EnzoSenatori/Geratrix_IoT_front/docs/referencias/fotos-esp32/esp32-1.jpeg

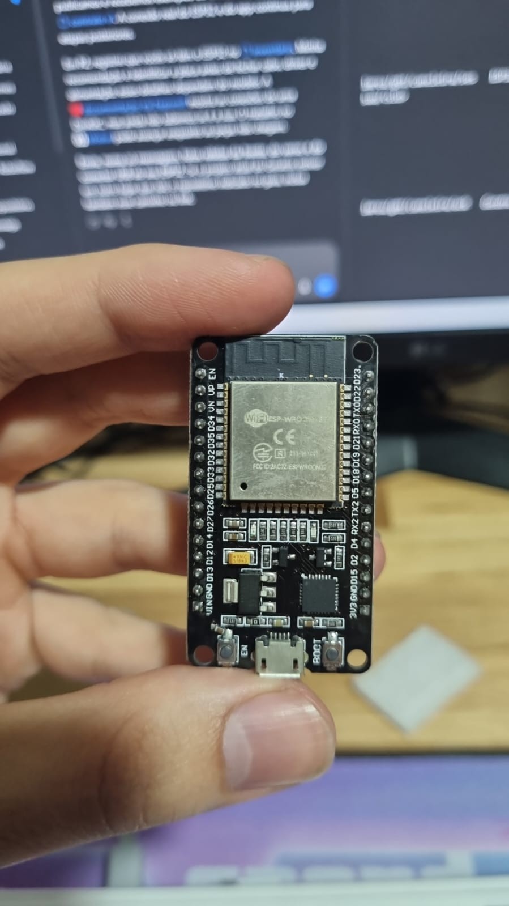
docs/referencias/fotos-esp32/esp32-1.jpeg
