EnzoSenatori/Geratrix_IoT_front/firmware/caneleira/README.md

# Firmware da caneleira

**Estado em 06/11/2026.** O P3 (leitura da IMU a 100 Hz) foi verificado no Wokwi em 13/10. Os passos P5 a P7 (filtro, contagem e classificação das repetições, resumo da série) estão implementados, verificados em simulação no computador e executados no Wokwi em 01/11/2026, do início ao fim da sessão. O P8 (uso efetivo) e o P9 (biofeedback) foram verificados no Wokwi em 02/11/2026, com um potenciômetro no lugar do FSR e um LED no lugar do motor. O P10 (comunicação MQTT) e o P11 (queda, persistência e início offline) foram verificados em simulação no Wokwi e no MQTTX. Em 08/11/2026, a parte de código do P12 (série iniciada pelo botão e *deep sleep*) foi implementada e verificada no computador; falta rodá-la no Wokwi e na placa. A validação na placa real segue pendente. [Evidências do P11](../../evidencias/p11/)

## Arquivos

| Arquivo | Conteúdo |
|---|---|
| `caneleira.ino` | Configuração, leitura (simulada ou real), eventos, motor e comunicação MQTT (`estado`, `cmd`, `sessao/<sid>` e `ack`) |
| `processamento.h` | Lógica sem dependência do Arduino: calibração do giroscópio, filtro complementar, máquina de estados, classificação, séries e JSON |
| `sinal_simulado.h` | Gerador de repetições fictícias com resultado conhecido |
| `biofeedback.h` | Padrões de vibração tocados sem bloquear a amostragem (lógica pura) |
| `botao.h` | Filtro de trepidação do botão, sem bloquear a amostragem (lógica pura, P12) |
| `energia.h` | Regras de quando dormir em *deep sleep* e por quanto tempo (lógica pura, P12) |
| `certificado_ca.h` | Certificado raiz público do broker (DigiCert Global Root G2, válido até 2038), para a conexão TLS |
| `segredos.exemplo.h` | Modelo das credenciais. Copie como `segredos.h`, que o Git ignora, e preencha as senhas |
| `diagram.json`, `libraries.txt` | Circuito e bibliotecas do projeto Wokwi |

## Circuito no Wokwi

O `diagram.json` traz o circuito completo da caneleira. Cada peça provisória está no pino definitivo do mapa do guia (seção 6.2): na placa real, troca-se a peça, não o código.

| Peça no Wokwi | Representa | Pino | Na placa real |
|---|---|---|---|
| MPU-6050 | Sensor de movimento | GPIO 21 (SDA) e 22 (SCL) | MPU-6050 (GY-521) |
| Potenciômetro `fsr` | Sensor de pressão na tira | GPIO 34 | FSR 402 com divisor de 10 kΩ |
| Potenciômetro `bateria` | Tensão da bateria | GPIO 35 | Divisor de 2 × 100 kΩ ligado à LiPo |
| LED `motor` + resistor de 220 Ω | Motor de vibração | GPIO 26 | Transistor NPN, diodo 1N4148 e motor de 3 V |
| Botão `botao` | Início de série e despertar | GPIO 33 | Botão tátil de 12 mm ligado ao GND |

Os GPIOs 34 e 35 estão no ADC1, o único utilizável com o Wi-Fi ligado; o 33 pode acordar a ESP32 do *deep sleep*.

## Como rodar no Wokwi

1. Abra o [projeto P3 no Wokwi](https://wokwi.com/projects/477822826125465601), use **Save a copy** para ter a sua cópia e substitua o `diagram.json` pelo desta pasta.
2. Substitua todo o conteúdo de `sketch.ino` pelo de `caneleira.ino`.
3. Crie os arquivos `processamento.h`, `sinal_simulado.h`, `biofeedback.h`, `botao.h`, `energia.h` e `certificado_ca.h` (seta ▾ ao lado das abas → **New file...**) e cole neles o conteúdo dos arquivos desta pasta, com os mesmos nomes. Substitua também o `libraries.txt`.
4. Crie o `segredos.h` com o conteúdo de `segredos.exemplo.h`. Salve o projeto ainda com o marcador no lugar da senha; só então digite a senha do `teste_g01`, rode e **não salve mais**: o projeto do Wokwi é público.
5. Clique em ▶. As alterações não precisam ser salvas para rodar. Com `USAR_REDE = false`, o firmware funciona sem Wi-Fi nem broker.

Com `INICIO_PELO_BOTAO = true` (padrão desde o P12), cada série espera um clique no botão verde: o monitor mostra `Serie N: aperte o botao para comecar.` Para repetir os roteiros anteriores sem clicar, ponha `INICIO_PELO_BOTAO = false`.

Com `USAR_SINAL_SIMULADO = true`, o sensor virtual é ignorado e o firmware processa o roteiro fictício. A primeira série termina em cerca de 45 s, e a sessão completa, em menos de 3 min.

Com `USAR_REDE = true` e o broker disponível na partida, o firmware aguarda a prescrição pelo `cmd` ou retoma a sessão pendente gravada. Se a partida ficar 15 s sem broker e houver uma prescrição salva, inicia uma sessão com um `sid` novo após calibrar e detectar uso efetivo. Com `USAR_REDE = false`, usa `PRESCRICAO_TESTE`, a sessão `sim001` com 3 séries de 10 repetições.

**Resultado esperado.** Em cada série: 10 repetições, 7 válidas, 2 fora do padrão por ADM e 1 por velocidade (perto de 220 °/s). A posição de cada uma muda de série para série, porque o roteiro segue de onde parou. Ao fim de cada série, uma linha `sessao/<sid> -> {...}` com o resumo no formato do contrato:

```text
Serie 1, rep  9/10 | ADM  69.8 | vel 220.1 graus/s | sobe 0.5 s | desce 0.9 s | FORA (vel)
  [vibracao] 2 pulsos curtos - repeticao fora do padrao
Serie 1, rep 10/10 | ADM  69.0 | vel  77.7 graus/s | sobe 1.3 s | desce 1.5 s | VALIDA
  [vibracao] 1 pulso curto - repeticao valida
  [vibracao] 3 pulsos curtos - fim de serie
sessao/sim001 -> {"sid":"sim001","status":"descanso","series":[{"n":1,"validas":7,"total":10,"adm_media":65.3,"vel_pico":220.1,"desvios":{"adm":2,"vel":1},"t_conc":1.2,"t_exc":1.5}],"ts":null}
```

## Teste com o MQTTX: `cmd`, `sessao` e `ack`

O MQTTX Web faz o papel do app. Conexão: `wss://z2f0d126.ala.eu-central-1.emqxsl.com`, porta 8084, caminho `/mqtt`, usuário `teste_g01`. Assine `imrea/g01/caneleira/#` com QoS 1.

1. Feche outras abas do Wokwi com este projeto: duas caneleiras com o mesmo client ID (`caneleira-01`) derrubam uma à outra. Deixe o Wokwi e o MQTTX lado a lado, visíveis: o navegador desacelera abas em segundo plano.
2. Rode e espere `MQTT: assinaturas cmd ok, ack ok.`
3. Publique em `imrea/g01/caneleira/cmd`, QoS 1, sem *retain*, só o JSON:
   `{"sid":"s7f3a","series":2,"reps":10,"adm_min":60,"vel_max":150,"descanso":10}`
   O monitor mostra `MQTT: prescricao recebida (sessao s7f3a).` e a série 1 começa.
4. Reenvie o mesmo `cmd` durante a série: `MQTT: cmd repetido da sessao atual; ignorado.`
5. No fim da série 1, chega `sessao/s7f3a` no MQTTX. Publique em `imrea/g01/caneleira/ack`: `{"sid":"s7f3a","series_recebidas":1}`.
6. Depois de `Sessao concluida.`, publique `{"sid":"s7f3a","series_recebidas":2}`: o monitor mostra `MQTT: sessao toda confirmada; mensagem retida apagada.`, e o MQTTX recebe uma mensagem vazia em `sessao/s7f3a`.

**Queda de conexão (P11).** Com uma sessão em andamento, abra no MQTTX uma segunda conexão com o Client ID `caneleira-01`, o mesmo da ESP32, durante uma série. O broker derruba a ESP32, e o monitor mostra `MQTT: conexao perdida`. Desconecte essa segunda conexão antes do fim da série. Ao terminar a série, o serial informa que o resumo ficou pendente. No descanso, a ESP32 reconecta e o resumo acumulado chega em `sessao/<sid>` na conexão principal do MQTTX. A contagem segue durante a queda. [Roteiro dos demais testes do P11](../../evidencias/p11/)

Se o `cmd` não fizer efeito, o monitor diz onde parou: sem `MQTT: mensagem recebida`, a mensagem não chegou à ESP32 (confira se o MQTTX recebe o próprio envio; se não recebe, desconecte e conecte o MQTTX de novo); com ela, mas sem `prescricao recebida`, o conteúdo foi recusado e a linha seguinte diz o motivo; `MQTT: conexao perdida (codigo -4)` indica falta de resposta do broker, e `-3`, conexão fechada, por exemplo por outro cliente com o mesmo ID.

## Botão e baixo consumo (P12)

**Botão (GPIO 33, ligado ao GND, com pull-up interno).** O firmware lê o pino a cada volta do `loop()` e só aceita o aperto depois de 30 ms estáveis (`botao.h`). Um aperto:

| Quando | Efeito |
|---|---|
| Série aguardando o botão (início da sessão ou fim do descanso) | Começa a contar as repetições; 1 pulso curto confirma |
| Durante o descanso | Encerra o descanso e começa a próxima série na hora; o pulso longo de fim de descanso confirma |
| Sem sessão, com prescrição salva e sem broker (partida offline do P11) | Começa a sessão offline sem esperar os 15 s, assim que a caneleira estiver presa; o mesmo aperto já libera a série 1 |
| Sem sessão e sem prescrição | Nada; o monitor lembra que falta o `cmd` |
| Com a ESP32 dormindo | Acorda a ESP32 (ext0) |

Movimento antes do botão não conta como repetição. Enquanto a série aguarda o botão, o `status` publicado continua `em_execucao`: o contrato não muda.

**Deep sleep (`energia.h`).** Só com `USAR_REDE = true`, porque depende da gravação das séries na memória não volátil (P11). A ESP32 dorme em dois casos:

| Caso | Condição | Acorda por |
|---|---|---|
| Descanso | Faltam 20 s ou mais de descanso | Timer, 4 s antes do fim (partida e 2 s de calibração), ou botão |
| Ociosa | Sem sessão ou com a sessão concluída, 5 min sem atividade (botão, mensagem MQTT, evento da sessão ou mudança do uso) | Só o botão |

Nunca dorme durante uma série, nem enquanto calibra, toca uma vibração ou espera o `ack` (até 5 s depois do fim da série, com o broker conectado). Antes de dormir, publica `{"online":false}` retido em `estado`, como o contrato pede, desliga o Wi-Fi, põe a MPU-6050 em *sleep* e prende a base do transistor em LOW. Ao acordar do descanso, recupera a sessão gravada, recalibra o giroscópio (perna parada por 2 s), toca o pulso longo e segue para a próxima série; se acordou pelo botão, a série já começa. Resumos ainda sem `ack` são reenviados na reconexão, como no P11.

**Teste no Wokwi.** Com o MQTTX, envie um `cmd` com `"descanso":30` e clique no botão para começar a série 1. No fim da série, o monitor mostra `P12: deep sleep (descanso)` e, pouco antes do fim dos 30 s, `P12: acordou pelo timer.`, seguido de `NVS: resumo recuperado` e `Serie 2: aperte o botao para comecar.` Clicar no botão durante o sono acorda a ESP32 na hora.

## Roteiro simulado (uma série, repetida sem fim)

| Rep. | Caso | Amplitude | Subida | Resultado esperado |
|---:|---|---:|---:|---|
| 1, 2, 6, 7, 10 | Normal | 66–71° | 1,4–1,5 s | Válida |
| 3 | Tremor de ±1,5° no topo | 72° | 1,4 s | Válida, contada uma vez |
| 4 | Incompleta | 45° | 1,2 s | Fora (ADM) |
| 5 | Pausa de 2 s no topo | 70° | 1,4 s | Válida, contada uma vez |
| 8 | Incompleta | 50° | 1,3 s | Fora (ADM) |
| 9 | Rápida | 70° | 0,5 s | Fora (velocidade) |

O gerador acrescenta ruído ao acelerômetro e ao giroscópio e um offset de 1,7 °/s no giroscópio, que a calibração inicial precisa remover.

## Definições adotadas

- **Ângulo θ:** 0° com a perna pendente e cerca de 90° estendida, pelo filtro complementar `θ = α·(θ + ω·Δt) + (1 − α)·θ_acc`, com α = 0,98.
- **Repetição:** contada quando a perna sobe acima de 15°, desce 5° abaixo do pico e volta abaixo de 10°, no fim da descida. Se o ângulo voltar a passar do pico, a subida é retomada, sem nova contagem.
- **ADM:** pico menos o ângulo de repouso anterior à repetição.
- **Velocidade de pico:** maior velocidade de subida medida pelo giroscópio.
- **Fases:** concêntrica é o tempo com ω acima de +10 °/s; excêntrica, o tempo abaixo de −10 °/s. Pausas no topo ficam fora das duas.
- **Classificação:** válida se ADM ≥ `adm_min` e velocidade de pico ≤ `vel_max`. Uma repetição pode ter os dois desvios. Sem uso efetivo durante toda a repetição, o movimento não é contado.
- **Uso efetivo:** tensão do divisor do FSR no GPIO 34, com histerese: presa a partir de 1,2 V, solta abaixo de 0,8 V; entre os dois, mantém o estado. Valores provisórios. Com `USAR_FSR = false`, a caneleira é considerada sempre presa.
- **Reinício do detector:** depois de um descanso, uma nova repetição só é aceita quando a perna é vista em repouso (abaixo de 10°); assim, a descida em curso no fim do descanso não vira repetição.
- **Biofeedback:** 1 pulso curto para repetição válida, 2 para fora do padrão, 3 no fim da série e 1 longo no fim do descanso; pulsos de 150 ms (longo, 600 ms), 150 ms entre pulsos e 500 ms entre padrões. Os padrões entram numa fila e tocam pelo PWM do GPIO 26, consultando `millis()` a cada volta do `loop()`, sem `delay()`.
- **Comunicação:** o Wi-Fi conecta sem bloquear. A conexão segura ao broker trava a ESP32 por 1 a 2 s, por isso só é tentada fora de uma série, com espera crescente de 2 s a 30 s entre tentativas. Na conexão, a caneleira registra o aviso de desconexão `{"online":false}`, retido, e publica `estado` na conexão, quando o uso muda e a cada 60 s. O buffer da PubSubClient foi ampliado de 256 para 1024 bytes: o maior resumo possível, com 6 séries, tem cerca de 810 bytes.
- **Prescrição (`cmd`):** aceita só se o `sid` tiver de 1 a 15 caracteres, sem `/`, `+` ou `#`, e se séries (1 a 6, o limite de memória `MAX_SERIES`), repetições (1 a 50), `adm_min` (até 120°), `vel_max` (até 500 °/s) e descanso (até 600 s) forem coerentes. São limites técnicos de coerência dos dados, não clínicos. Antes da calibração terminar, a prescrição fica guardada e a sessão começa logo depois dela. O mesmo `sid` reenviado é ignorado, como pede o contrato, e um `cmd` com outro `sid` também é ignorado enquanto houver sessão em andamento.
- **Resumo e confirmação (`sessao/<sid>` e `ack`):** ao fim de cada série, o resumo acumulado é publicado retido. Sem conexão, sai assim que a caneleira reconectar, enquanto o app não confirmar todas as séries. O `ack` nunca confirma mais séries do que as já concluídas. Com a sessão concluída e toda confirmada, uma publicação vazia e retida apaga a mensagem no broker.
- **Wokwi e tempo real:** o simulador roda a cerca de 50% do tempo real, e o broker conta o tempo real. Com `NO_WOKWI = true`, o `estado` sai a cada 20 s e o keepalive sobe para 60 s, para o broker não dar a caneleira por desconectada. Na placa real, `NO_WOKWI = false` volta aos 60 s do contrato e ao keepalive de 15 s.
- **Bateria:** o GPIO 35 lê metade da tensão da LiPo; 3,3 V vira 0% e 4,2 V vira 100%, em aproximação linear provisória.
- **Resumo da série (a validar com o Rafael):** `adm_media`, `t_conc` e `t_exc` são médias de todas as repetições; `vel_pico` é o máximo da série; `status` vale `descanso` entre séries e `concluida` ao final; `ts` é `null` até haver hora de rede.

## Constantes a calibrar em bancada

Ficam no topo de `processamento.h`: `ALFA_FILTRO`, `THETA_INICIO_GRAUS`, `DELTA_PICO_GRAUS`, `THETA_FIM_GRAUS`, `OMEGA_MOVIMENTO_GRAUS_S`, `AMOSTRAS_CALIBRACAO`, `SINAL_GIRO`, `USO_LIGA_MV` e `USO_DESLIGA_MV`; no topo de `biofeedback.h`, as constantes `VIB_...`; no `caneleira.ino`, `INTENSIDADE_MOTOR`. Os eixos de `anguloAcelerometro()` e o sinal do giroscópio são provisórios e devem ser confirmados no P4, com a placa presa à caneleira.

## Teste no computador

A lógica pode ser testada sem Arduino nem Wokwi:

```bash
cd firmware/testes
g++ -std=c++17 -Wall -Wextra -I../caneleira teste_processamento.cpp -o teste && ./teste
```

O teste percorre o roteiro inteiro e confere o offset removido, o erro do ângulo filtrado (máximo observado: 1,7°) e o resultado de cada série. Confere também a histerese do uso, o reinício do detector após o descanso, a validação da prescrição e a espera pelo `cmd` depois da calibração. Desde o P12, confere o filtro do botão, a sessão completa com cada série iniciada pelo botão, o botão no descanso e as regras do *deep sleep*.

**Teste de bancada.** `firmware/testes/teste_bancada_esp32/` confere cada peça da protoboard na ESP32 real, sem biblioteca e com os mesmos pinos. É o primeiro programa a gravar na placa; o roteiro está em `docs/montagem-protoboard.md`.

## Limites desta versão

- A simulação não reproduz a aceleração linear do movimento, que existirá na placa real e pode exigir outro α.
- A persistência é feita ao terminar cada série. Se houver um reinício no meio da série, as repetições parciais são descartadas e a próxima execução retoma a partir da última série concluída.
- A caneleira mantém uma sessão pendente por vez e aguarda o ACK final antes de aceitar outra. A partida automática sem broker exige prescrição salva e uso efetivo.
- A sessão iniciada sem broker recebe um `sid` criado pela caneleira, sem ligação com o residente. O app precisa assinar `sessao/+` e confirmar toda sessão recebida: enquanto uma sessão não for toda confirmada, a caneleira recusa `cmd` novo, inclusive depois de reiniciar. No MQTTX, basta publicar o `ack` com o `sid` novo. Uma correção foi testada no computador em 06/11 e não aplicada, porque muda o contrato: o resumo levaria o campo `origem`, com o `sid` da prescrição usada.
- A partida sem broker começa 15 s depois de ligar. Numa rede lenta, a sessão pode começar com a prescrição antiga, e o `cmd` do gestor só é aceito ao fim dela. Aumentar `ESPERA_BROKER_NA_PARTIDA_MS` reduz o risco; desde o P12, um aperto do botão antecipa a partida offline.
- **P12, só verificado no computador.** A lógica do botão e do *deep sleep* passou no teste do computador, e o `.ino` passou por uma checagem de sintaxe com cabeçalhos substitutos das bibliotecas; ainda não foi compilado na Arduino IDE nem rodou no Wokwi ou na placa. Pontos a observar: se o power bank se desliga com a ESP32 dormindo (`docs/autonomia.md`), se a base do motor fica em LOW durante o sono e quanto tempo o Wi-Fi e o TLS levam para voltar depois de acordar.
- **Dormindo, a caneleira não recebe o `cmd`,** que não é retido. Antes de enviar a prescrição, acorde-a pelo botão; o app vê `"online":true` no `estado` quando ela estiver pronta. O `ack` que chegar durante o sono se perde, mas o resumo é reenviado ao acordar e o app confirma de novo.
- Os tempos do P12 (`DESCANSO_MIN_PARA_DORMIR_S`, `ANTECEDENCIA_DESPERTAR_S`, `OCIOSO_PARA_DORMIR_MS`, `ESPERA_ACK_ANTES_DE_DORMIR_MS`) são provisórios.
- `TESTAR_REINICIO_P11` e `TESTAR_OFFLINE_P11` existem só para os testes no Wokwi: ficam em `false` e podem ser removidas antes da placa real.
- `ts` sai `null`: a ESP32 ainda não obtém a hora da rede (NTP).
- A vibração foi vista num LED; a distinção dos padrões na perna e a intensidade dependem do motor real.
- O FSR é simulado por um potenciômetro; os limiares de uso ainda não foram medidos.
- O roteiro simulado se repete sem fim, para que repetições descartadas num teste não esgotem o movimento.
- O giroscópio está configurado até 250 °/s; acima disso, a leitura satura.

## Histórico

**P3, 13/10/2026.** Primeiro projeto Wokwi: ESP32 DevKit V1 e MPU-6050 por I²C (SDA no GPIO 21, SCL no GPIO 22, 3,3 V e GND), leitura a 100 Hz. Com `accelX = accelZ = 0,7 g`, o ângulo foi 45,0°; com `rotationY = 60 °/s`, a velocidade foi 60,0 °/s; `dt_ms` ficou entre 9,99 e 10,01 ms. O projeto é público porque o link não listado exige plano pago; não contém credenciais nem dados de pacientes.
