EnzoSenatori/Geratrix_IoT_front/docs/referencias/fotos-esp32/esp32-3.jpeg

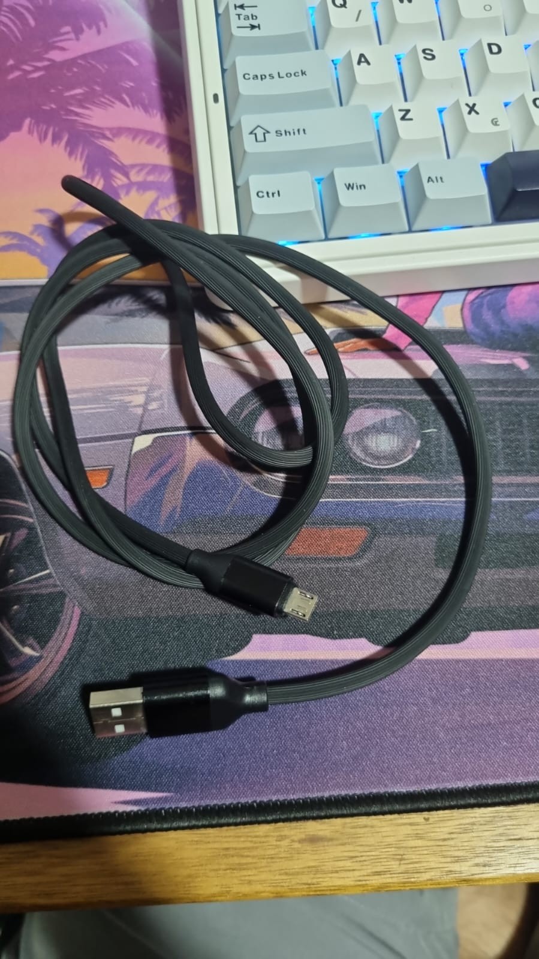
docs/referencias/fotos-esp32/esp32-3.jpeg
