EnzoSenatori/Geratrix_IoT_front/evidencias/p1-mqtt/1-comando.png

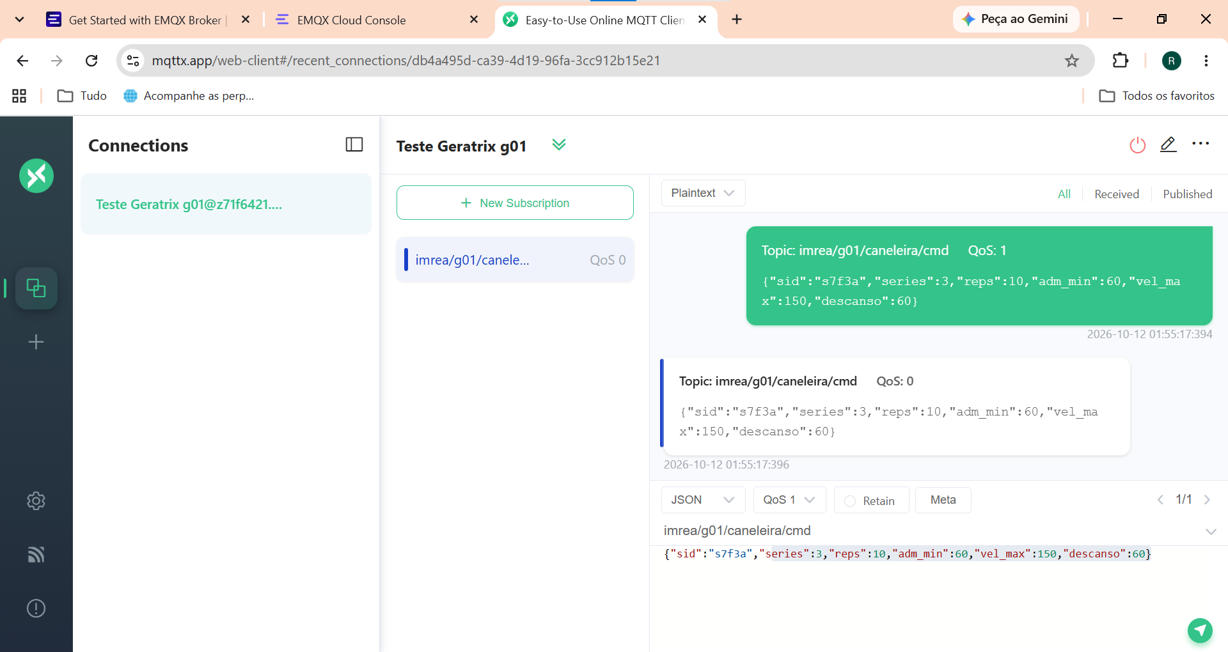
evidencias/p1-mqtt/1-comando.png
