EnzoSenatori/Geratrix_IoT_front/evidencias/p1-mqtt/2-estado.png

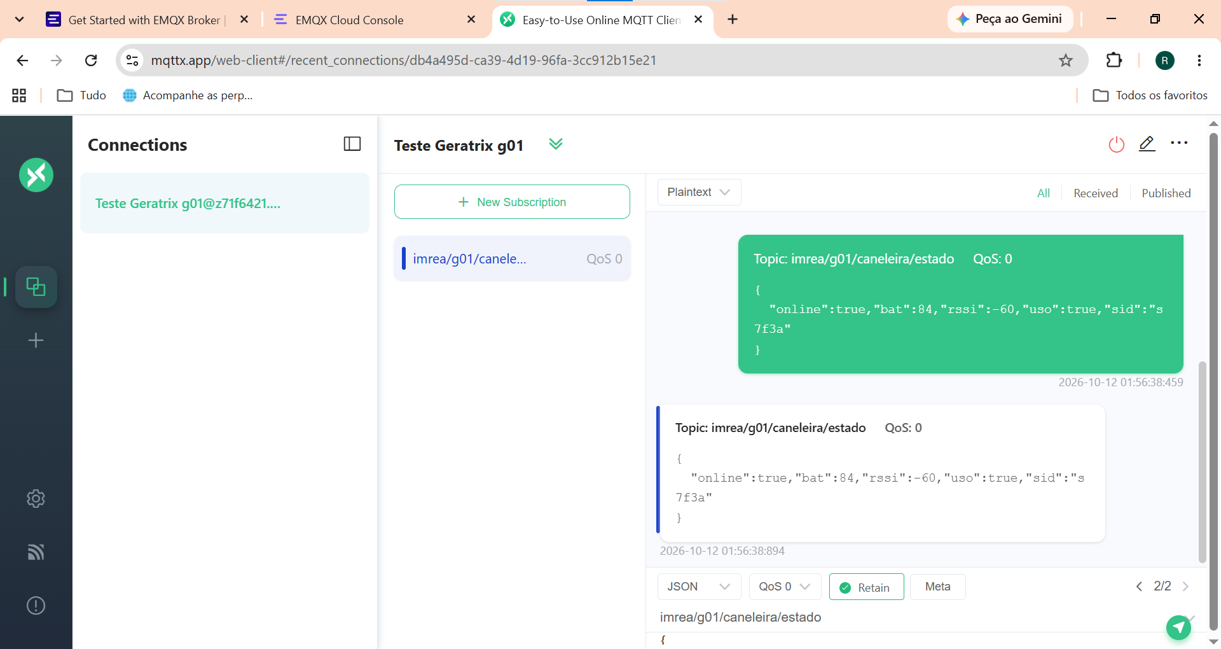
evidencias/p1-mqtt/2-estado.png
