EnzoSenatori/Geratrix_IoT_front/evidencias/p1-mqtt/3-retain.png

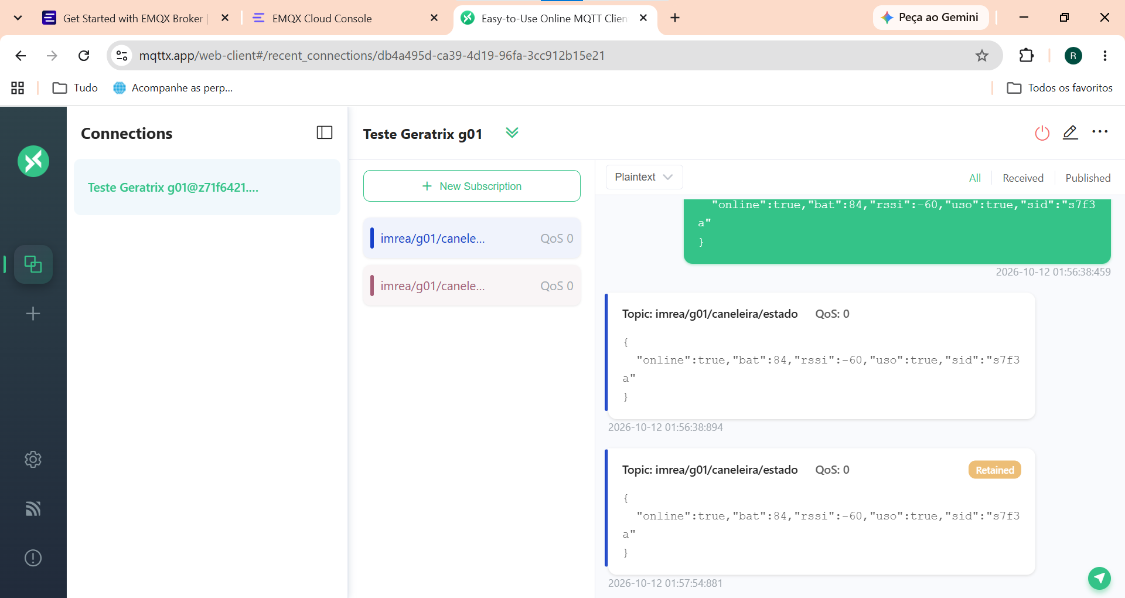
evidencias/p1-mqtt/3-retain.png
