EnzoSenatori/Geratrix_IoT_front/evidencias/p1-mqtt/4-sessao.png

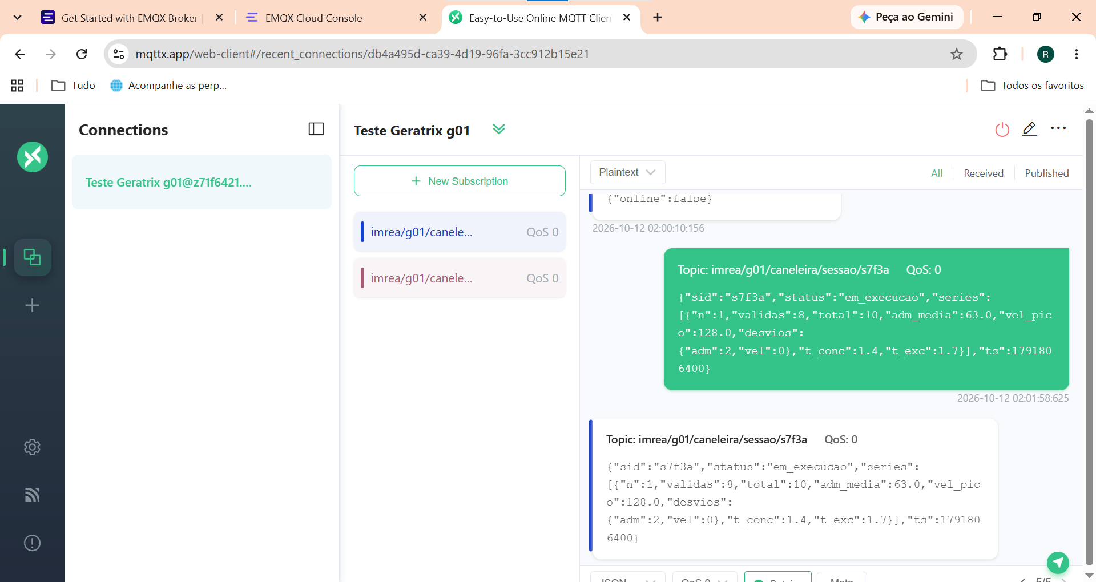
evidencias/p1-mqtt/4-sessao.png
