EnzoSenatori/Geratrix_IoT_front/evidencias/p1-mqtt/5-ack.png

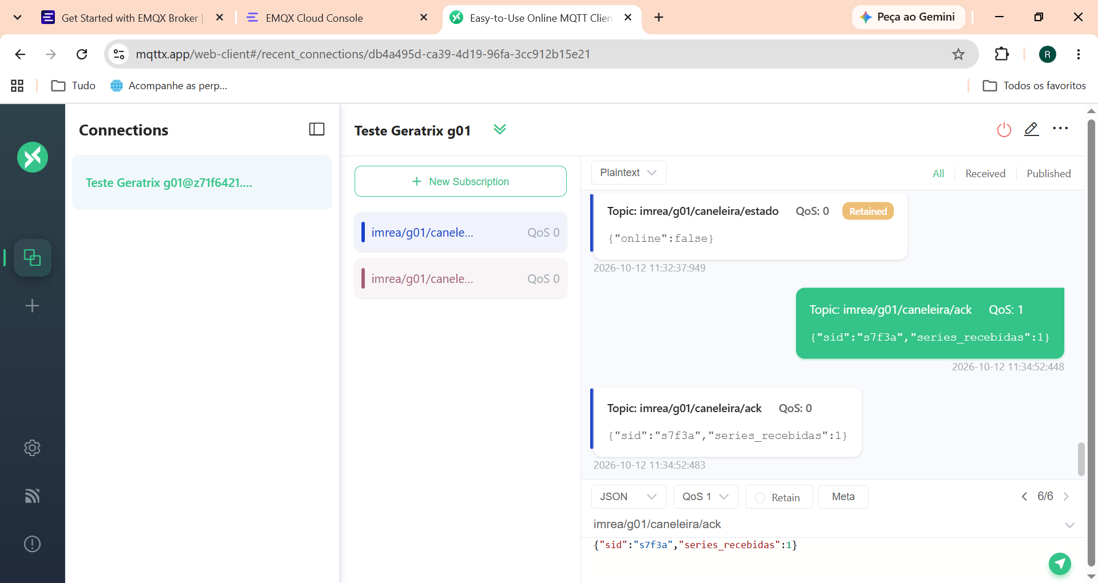
evidencias/p1-mqtt/5-ack.png
