EnzoSenatori/Geratrix_IoT_front/evidencias/p1-mqtt/6-limpeza-retained.png

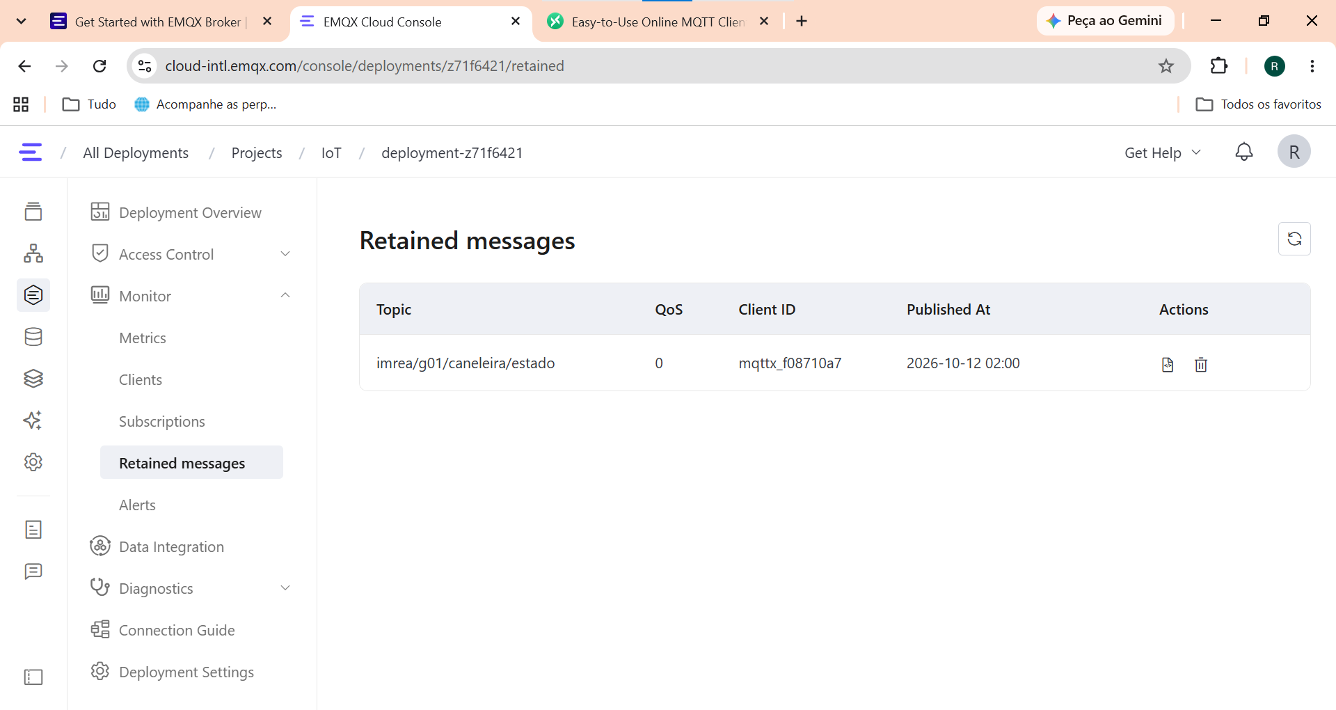
evidencias/p1-mqtt/6-limpeza-retained.png
