EnzoSenatori/Geratrix_IoT_front/evidencias/p5-p7/wokwi-sessao-concluida.png

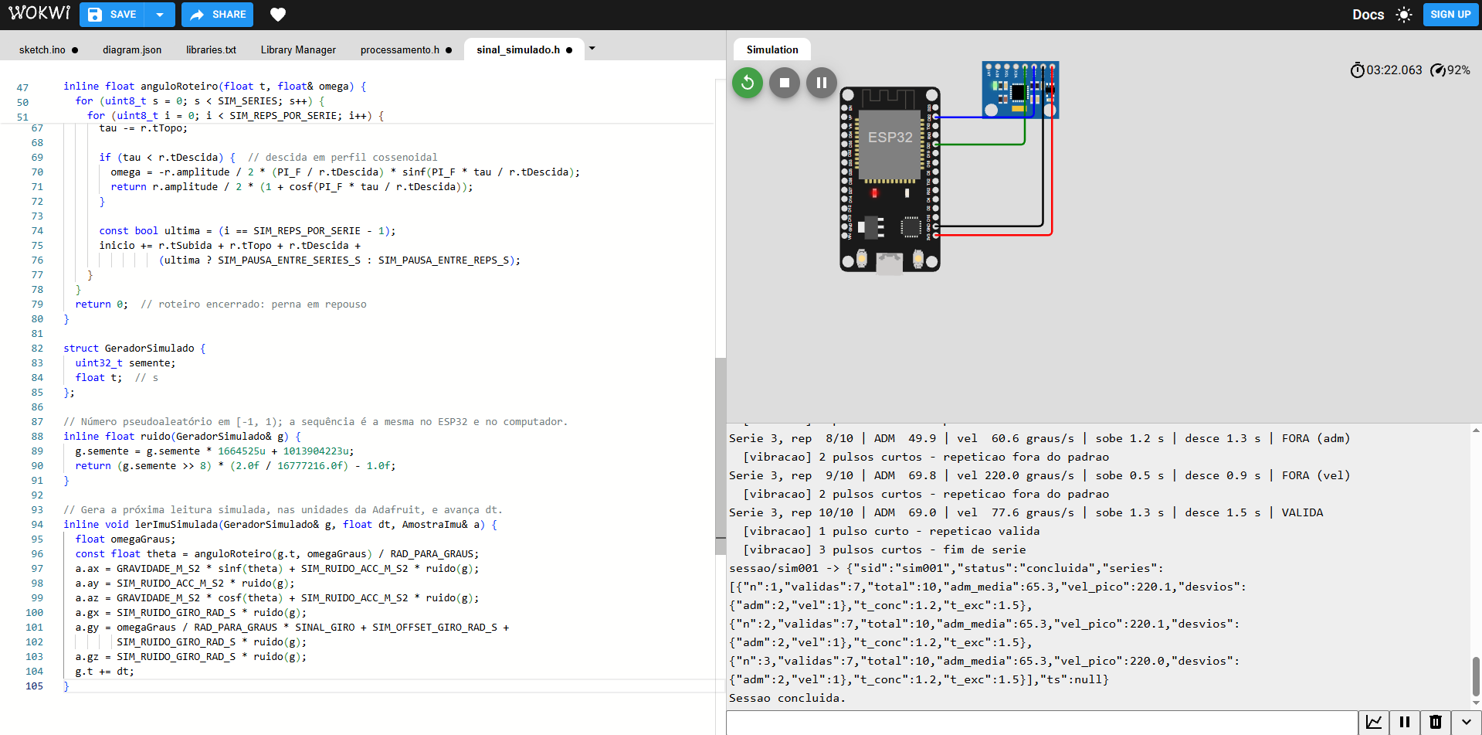
evidencias/p5-p7/wokwi-sessao-concluida.png
