EnzoSenatori/Geratrix_IoT_front/evidencias/p8/wokwi-uso-efetivo.png

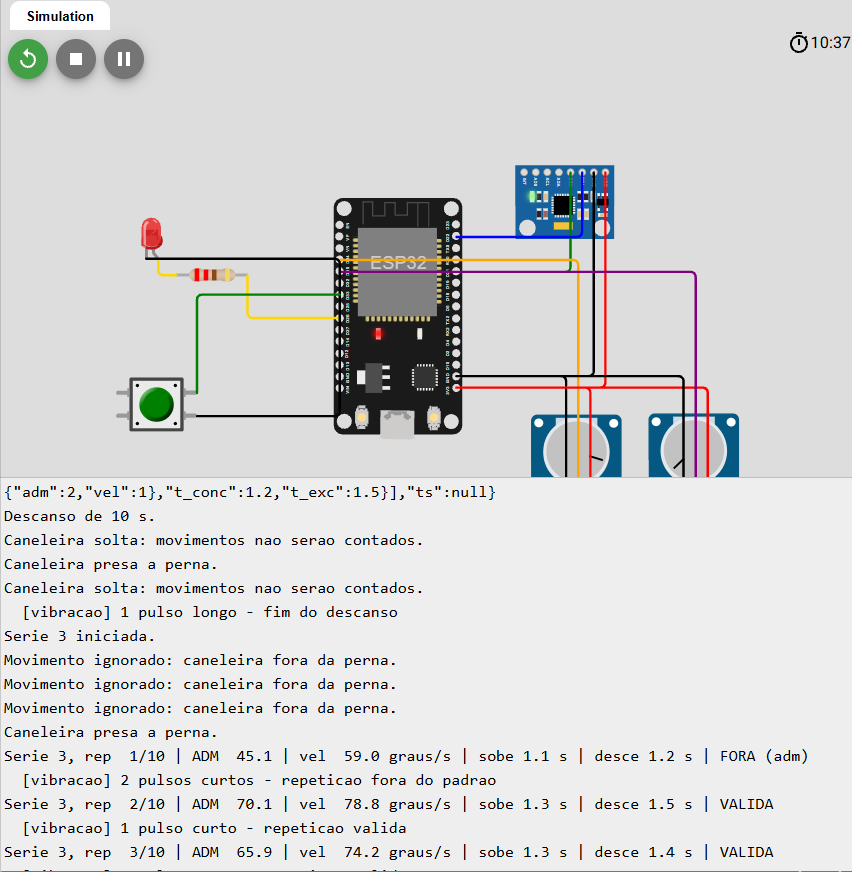
evidencias/p8/wokwi-uso-efetivo.png
