EnzoSenatori/Geratrix_IoT_front/evidencias/p11/offline-ack-serial.png

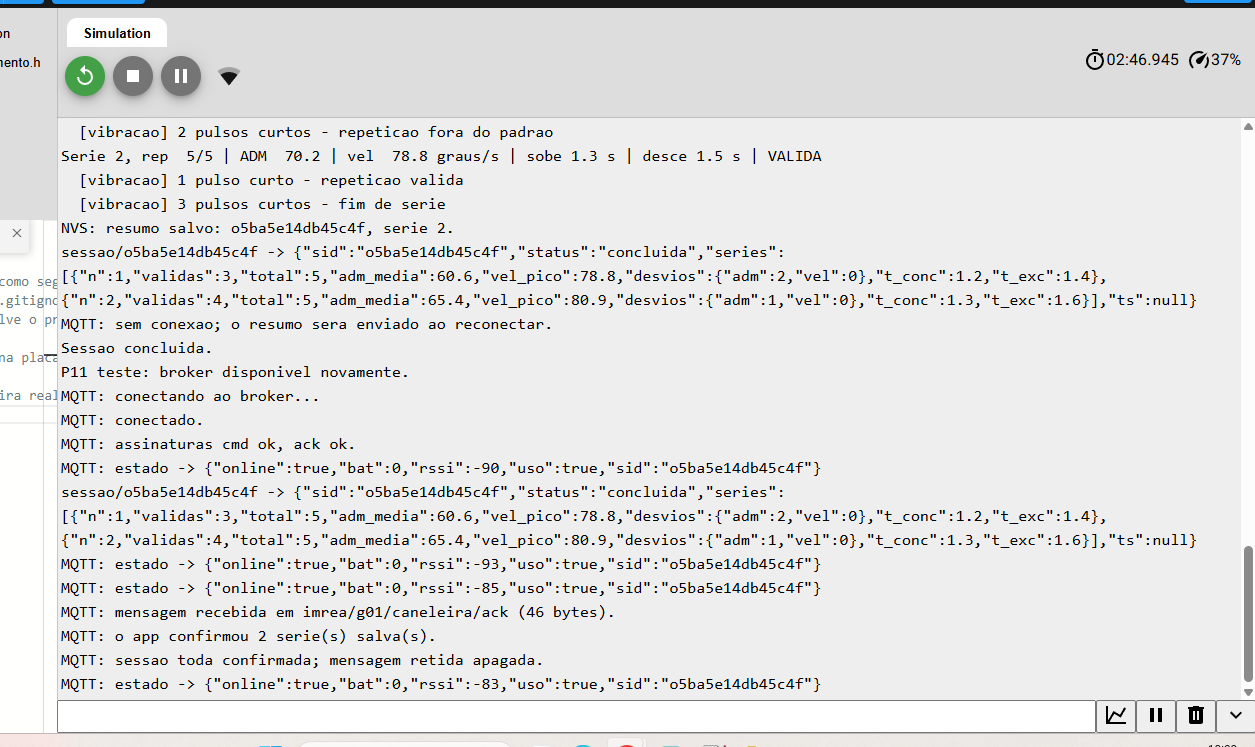
evidencias/p11/offline-ack-serial.png
