EnzoSenatori/Geratrix_IoT_front/evidencias/p11/offline-partida-serial.png

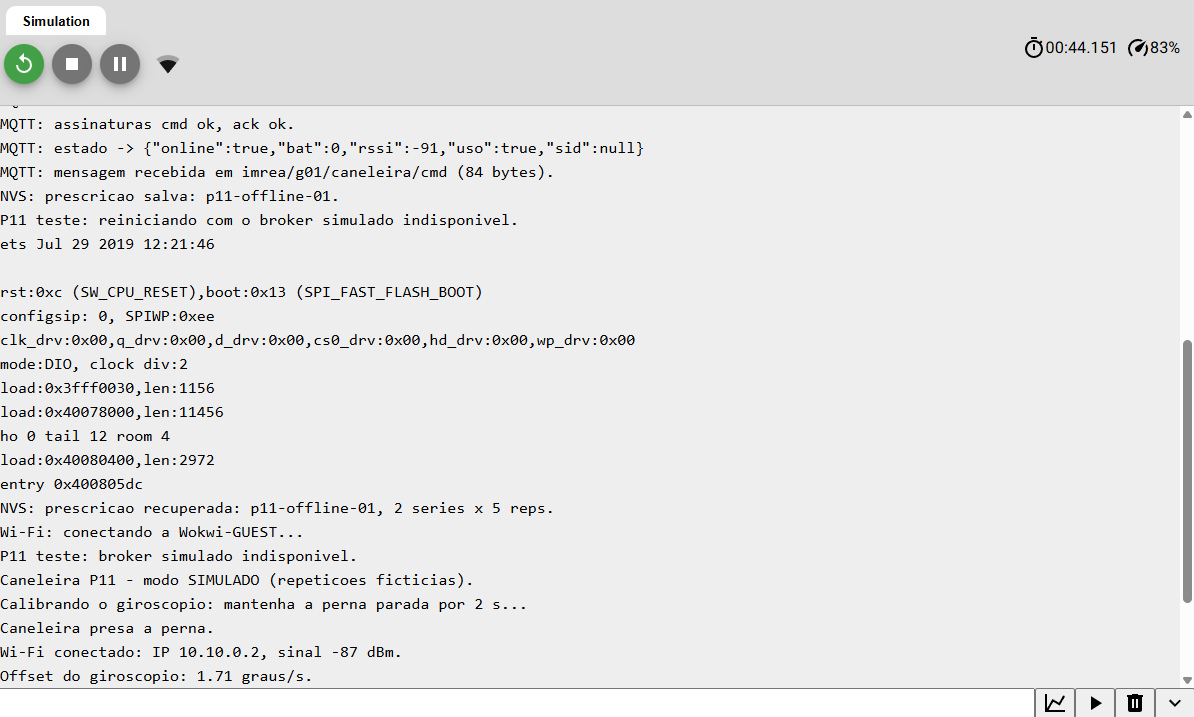
evidencias/p11/offline-partida-serial.png
