EnzoSenatori/Geratrix_IoT_front/evidencias/p11/offline-sincronizacao-mqttx.jpeg

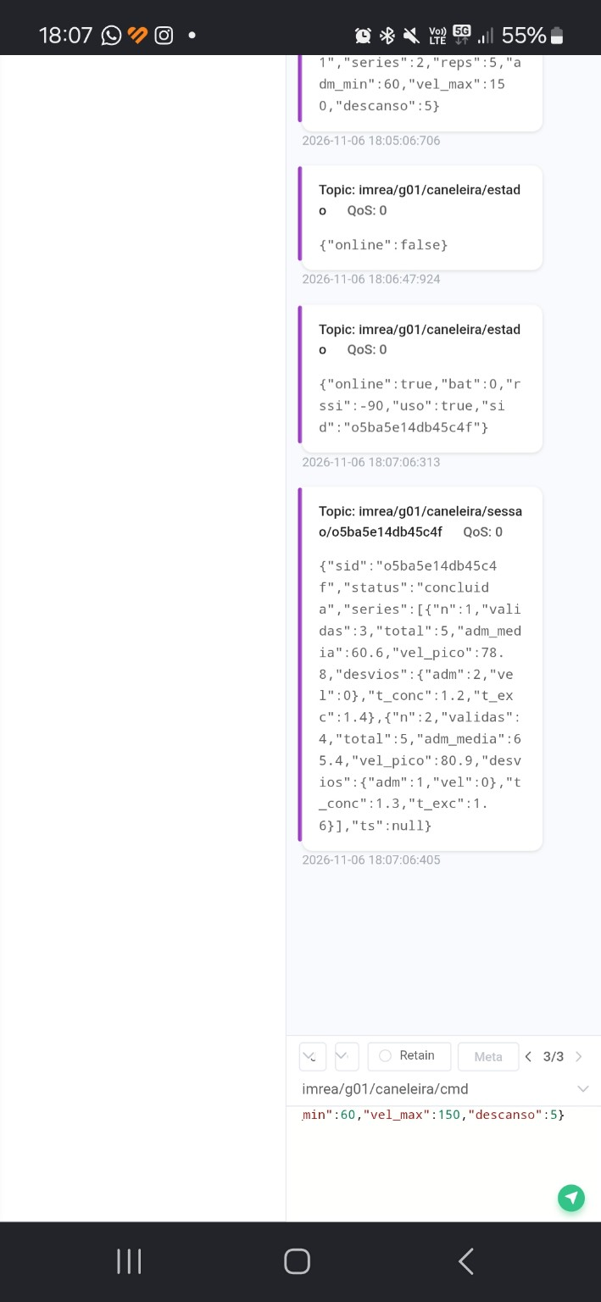
evidencias/p11/offline-sincronizacao-mqttx.jpeg
