EnzoSenatori/Geratrix_IoT_front/evidencias/p11/prescricao-reinicio-serial.png

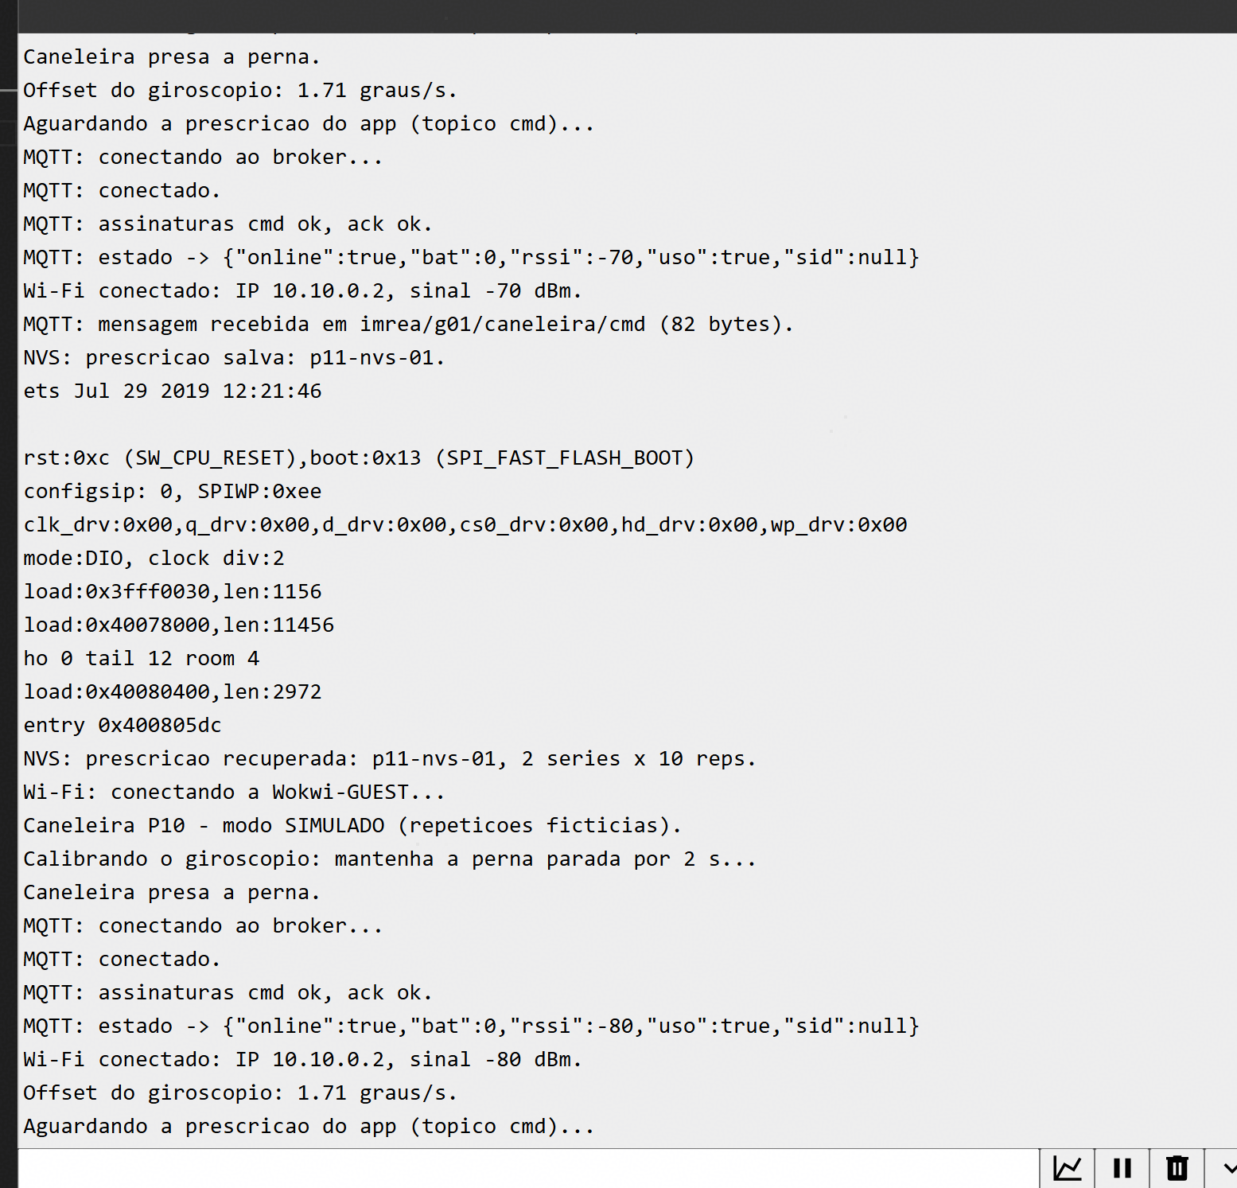
evidencias/p11/prescricao-reinicio-serial.png
