EnzoSenatori/Geratrix_IoT_front/evidencias/p11/queda-reconexao-mqttx.png

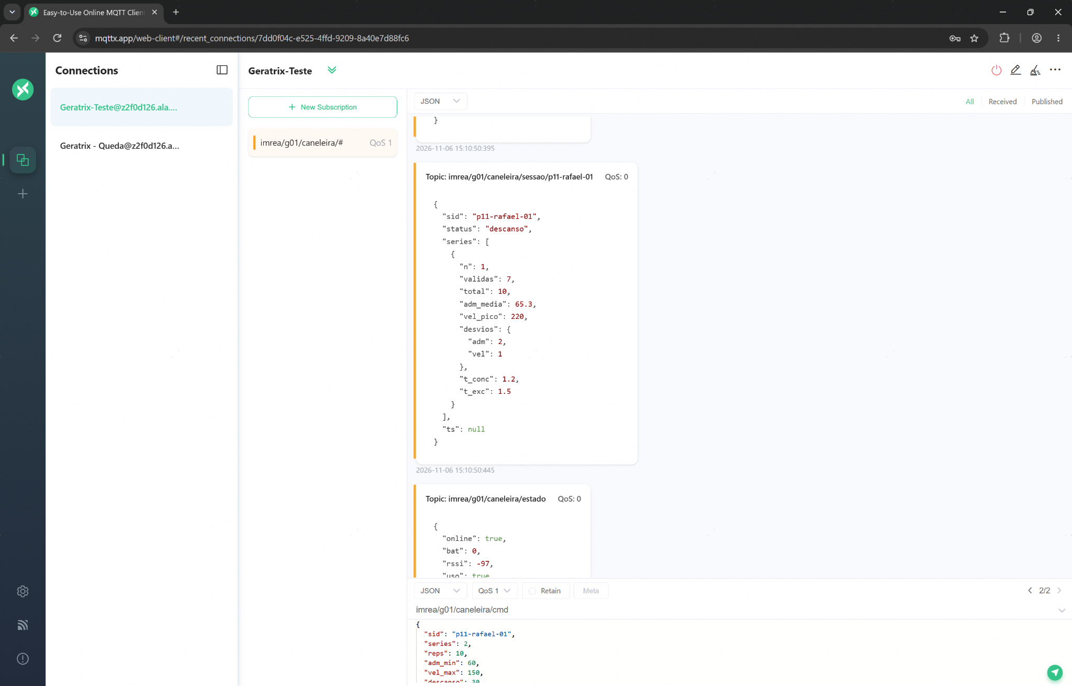
evidencias/p11/queda-reconexao-mqttx.png
