EnzoSenatori/Geratrix_IoT_front/evidencias/p11/queda-reconexao-serial.png

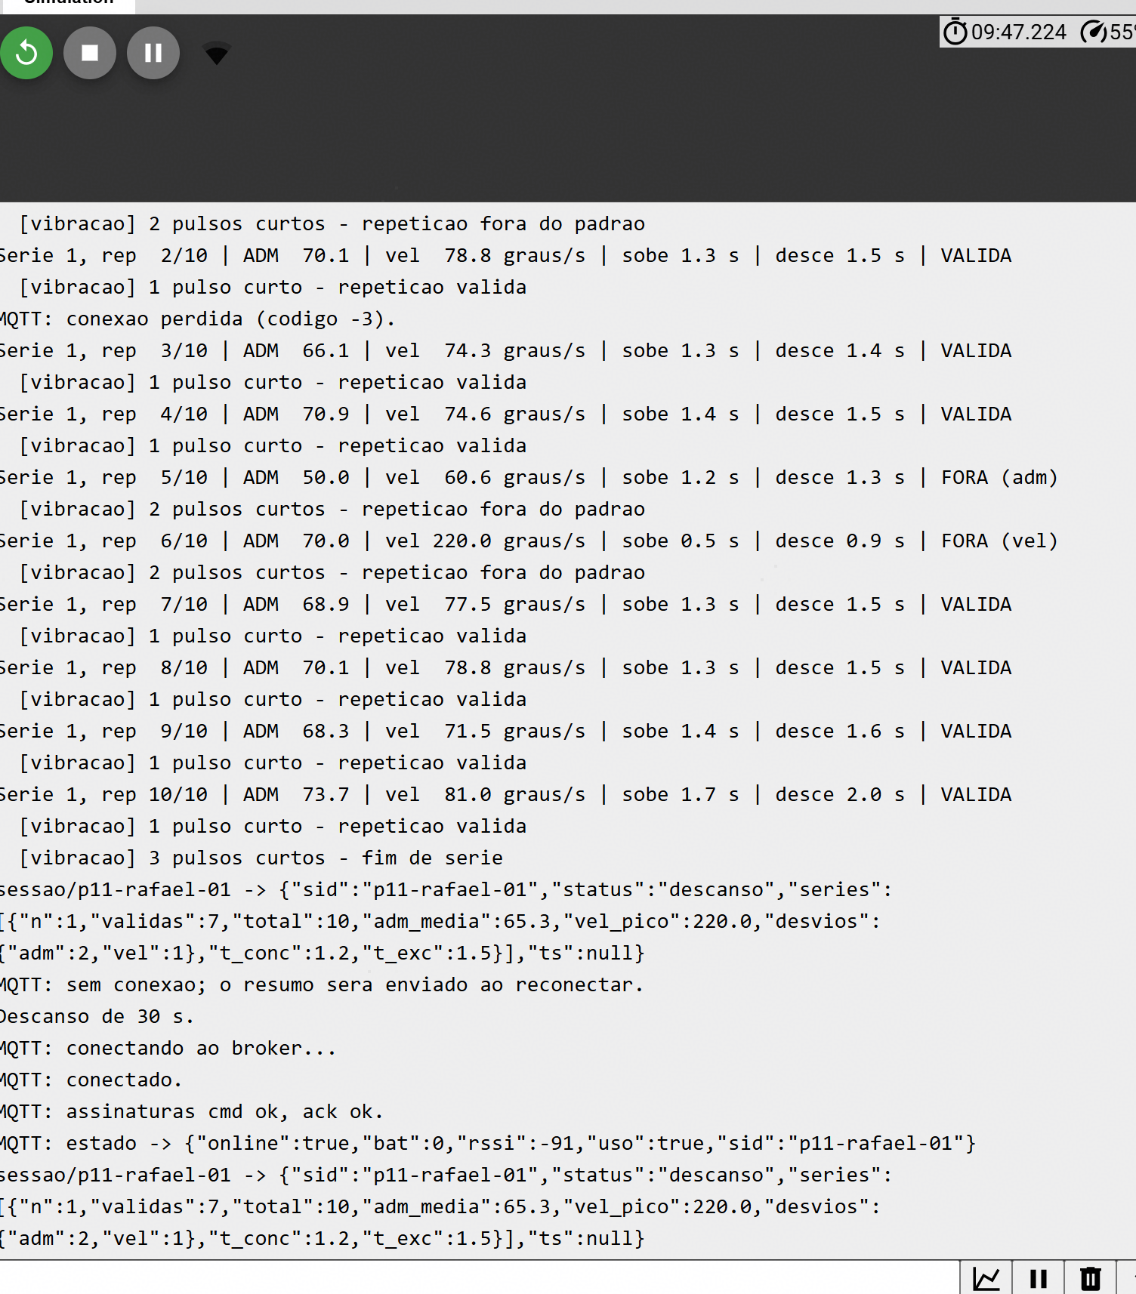
evidencias/p11/queda-reconexao-serial.png
