EnzoSenatori/Geratrix_IoT_front/evidencias/p11/resumo-reinicio-mqttx.jpg

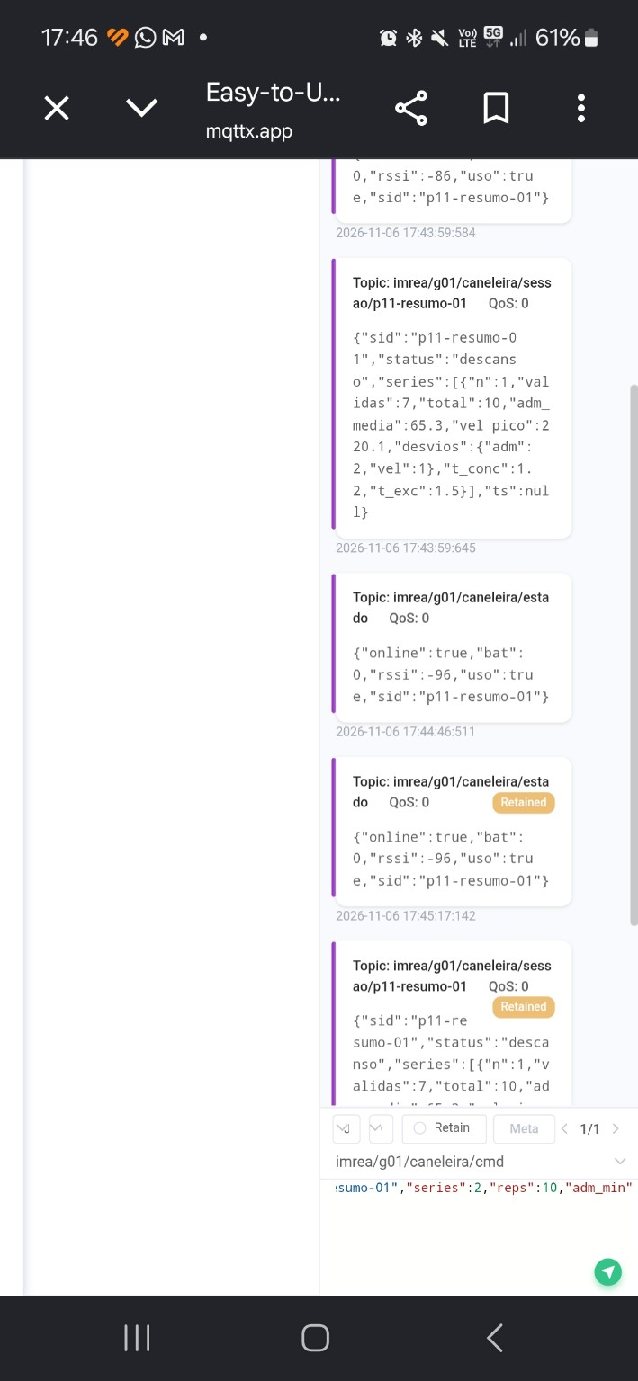
evidencias/p11/resumo-reinicio-mqttx.jpg
