EnzoSenatori/Geratrix_IoT_front/evidencias/p11/resumo-reinicio-serial.png

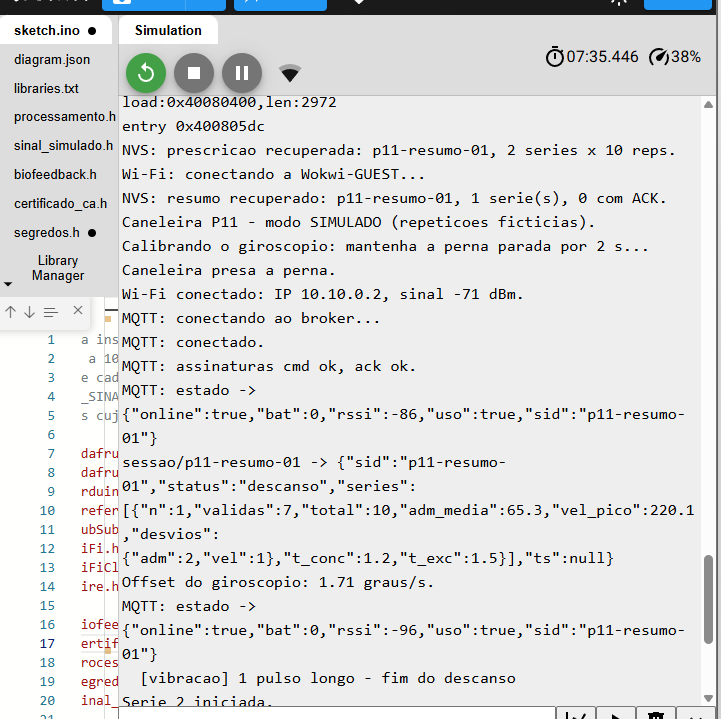
evidencias/p11/resumo-reinicio-serial.png
