EnzoSenatori/Geratrix_IoT_front/firmware/caneleira/segredos.exemplo.h

#pragma once
// Modelo das credenciais. Copie este arquivo como segredos.h e preencha as senhas.
// O segredos.h nunca vai para o Git (está no .gitignore). No Wokwi, que é público,
// digite a senha só na hora de rodar e não salve o projeto com ela.

#define WIFI_SSID "Wokwi-GUEST"  // no Wokwi; na placa real, a rede do local de teste
#define WIFI_SENHA ""
#define MQTT_USUARIO "teste_g01"  // na caneleira real: caneleira_g01
#define MQTT_SENHA "COLOQUE_A_SENHA_AQUI"
