EnzoSenatori/Geratrix_IoT_front/firmware/caneleira/certificado_ca.h

#pragma once
// Certificado raiz que assina o broker EMQX Cloud do projeto (DigiCert Global Root G2).
// É público: permite à ESP32 confirmar, na conexão TLS, que fala com o broker verdadeiro.
// Baixado do console do EMQX em 01/11/2026; válido até 15/01/2038.
// SHA-256: CB:3C:CB:B7:60:31:E5:E0:13:8F:8D:D3:9A:23:F9:DE:47:FF:C3:5E:43:C1:14:4C:EA:27:D4:6A:5A:B1:CB:5F
// Uso (P10): clienteTls.setCACert(CERTIFICADO_CA_EMQX);

static const char CERTIFICADO_CA_EMQX[] = R"PEM(-----BEGIN CERTIFICATE-----
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
MrY=
-----END CERTIFICATE-----
)PEM";
