EnzoSenatori/Geratrix_IoT_front/(commit log)

2026-11-01 Organiza o pacote de continuidade da caneleira (estado de 13/10)
    - docs: guia vivo, contrato MQTT v1, inventário de materiais, repasse do
    Rafael e fotos da placa
    - firmware/caneleira: código P3 (leitura da IMU a 100 Hz) e arquivos do Wokwi
    - app: telas estáticas do Geratrix em HTML/CSS, incluindo registro de
    exercício e histórico
    - evidencias/p1-mqtt: capturas do teste manual do contrato no MQTTX
    - Caminhos internos dos documentos atualizados para a nova estrutura;
    conteúdo técnico preservado
    - README com o estado real do projeto; .gitignore reserva segredos.h
    para credenciais
    - Enunciado e proposta ficam fora enquanto o repositório for público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
2026-11-01 Implementa contagem e classificação das repetições (P5 a P7)
    - processamento.h: calibração do offset do giroscópio, filtro
    complementar, máquina de estados com histerese (REPOUSO, SUBINDO,
    DESCENDO, FINALIZANDO), métricas por repetição, classificação contra
    a prescrição, controle de séries e descanso, e resumo JSON no formato
    do tópico sessao/<sid> do contrato v1
    - sinal_simulado.h: roteiro de 30 repetições fictícias com resultado
    conhecido (normais, incompletas, rápida, tremor e pausa no topo),
    com ruído e offset de giroscópio
    - caneleira.ino: modo simulado ou MPU-6050 real, amostragem não
    bloqueante a 100 Hz, impressão dos eventos e biofeedback provis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
2026-11-01 Migra o broker para a conta do Enzo (contrato v1.1)
    - Contrato: nova conexão (z2f0d126.ala.eu-central-1.emqxsl.com, portas
    8883 e 8084), usuário teste_g01 e histórico de versões. Tópicos,
    payloads, unidades, QoS e retenção inalterados
    - Guia vivo, README e repasse atualizados; validação P1 registrada como
    feita no broker anterior
    Claude-Session: https://claude.ai/code/session_01D4xvNFQ4Ujg2AaZLdNpqRc
2026-11-01 Adiciona o certificado raiz do broker para a conexão TLS da ESP32
    DigiCert Global Root G2, baixado do console do EMQX em 01/11/2026
    (válido até 2038). Certificado público; nenhuma credencial incluída.
    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
    [certificado_ca.h]
2026-11-01 Registra no guia vivo a frente de trabalho sem hardware
    Ordem acordada em 01/11/2026, com critério de pronto de cada item.
    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
2026-11-02 Adiciona o guia de continuidade para o grupo
    docs/como-continuar.md: estado em 01/11/2026, próximos itens com
    critério de pronto, organização do repositório, forma de trabalhar,
    testes, credenciais, regras fixas, método com IA (com prompt pronto)
    e divisão proposta. Aprovado por Enzo em 02/11/2026.
    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
2026-11-02 Implementa o uso efetivo pelo sensor de pressão (P8)
    - processamento.h: detector de uso com histerese (presa a partir de
    1,2 V, solta abaixo de 0,8 V; valores provisórios)
    - caneleira.ino: leitura do FSR no GPIO 34 e aviso de presa/solta;
    movimento sem uso efetivo não é contado
    - sinal_simulado.h: roteiro que se repete sem fim, para repetições
    descartadas não esgotarem o movimento simulado
    - diagram.json: circuito completo no Wokwi (FSR e bateria como
    potenciômetros, LED no lugar do motor, botão), nos pinos definitivos
    - teste_processamento.cpp: teste da histerese
    - README, README do firmware, guia vivo e evidência em evidencias/p8
    Testado no computador (todas as verifica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
2026-11-02 Corrige repetição espúria após o descanso
    Depois de reiniciado (fim do descanso), o detector só aceita nova
    repetição ao ver a perna em repouso, abaixo de THETA_FIM. Antes, se o
    descanso terminava no meio de um movimento, a descida em curso era
    contada como repetição com ADM 0, fora do padrão.
    Encontrado ao simular no computador o vaivém do sensor de uso; coberto
    por teste novo em teste_processamento.cpp. Verificado no Wokwi em
    02/11/2026. Aprovado por Enzo.
    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
    [processamento.h]
2026-11-02 Implementa o biofeedback por vibração (P9)
    - biofeedback.h: fila de padrões tocados sem bloquear a amostragem
    (1 pulso curto = válida, 2 = fora do padrão, 3 = fim de série,
    1 longo = fim do descanso), consultando millis() a cada volta
    - caneleira.ino: PWM do motor no GPIO 26 (LEDC, compatível com os cores
    2.x e 3.x da ESP32) e padrão por evento
    - README, README do firmware, guia vivo e evidência em evidencias/p9
    Verificado no Wokwi em 02/11/2026, com LED no lugar do motor: padrões
    nos momentos certos e sessão com o mesmo resultado de antes. Pendentes:
    contador de atrasos durante a vibração e sensação com o motor real.
    Aprovado por Enzo.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
2026-11-02 Conecta a caneleira ao broker e publica o estado (P10, parte 1)
    - caneleira.ino: Wi-Fi sem bloqueio; conexão TLS ao broker do grupo
    com o certificado raiz; last will {"online":false} retido; estado
    (bateria, sinal, uso, sid) na conexão, quando o uso muda e a cada
    60 s; reconexão só fora de uma série, com espera de 2 a 30 s
    - NO_WOKWI: no simulador, que roda a ~50% do tempo real, estado a cada
    20 s e keepalive de 60 s, para o broker não derrubar a conexão
    - segredos.exemplo.h (modelo, sem senha) e libraries.txt
    - README, README do firmware, guia vivo, como-continuar atualizado
    para 02/11 e evidência em evidencias/p10
    Verificado no Wokwi e no MQTTX em 02/11/2026: uma única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
    [caneleira.ino, segredos.exemplo.h]
2026-11-02 Recebe a prescrição pelo cmd e publica as séries com ack (P10, parte 2)
    - Com rede, a sessão espera o cmd depois da calibração; a prescrição é
    validada por limites técnicos de coerência, e o mesmo sid reenviado é
    ignorado
    - Cada série sai retida em sessao/<sid>; sem conexão, o resumo sai ao
    reconectar, enquanto houver série não confirmada
    - O ack nunca confirma série ainda não concluída; o ack final apaga a
    mensagem retida com publicação vazia
    - Buffer da PubSubClient ampliado para 1024 bytes; mensagens de
    diagnóstico de assinatura, recebimento e queda de conexão
    - Testes de validação da prescrição e de espera pelo cmd
    - Verificado no Wokwi com o MQTTX no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
2026-11-03 Atribui as pendências ao Felipe e adota a lista de materiais versão 1 (D15)
    - Felipe entra no grupo e assume P11, o código do P12 e a documentação
    técnica; a integração com o app passa para depois do Flutter
    - Roteiro do teste de queda de conexão no README do firmware, primeiro
    teste do P11
    - Decisão D15: protótipo enxuto, com power bank pelo USB e mini
    protoboard, sem bateria LiPo nem circuito soldado
    - Inventário reescrito como lista de materiais versão 1, sem preços;
    power bank e caneleira já em mãos
    - Pendente com o Rafael: o que o campo bat do estado publica sem leitura
    de bateria
    Claude-Session: https://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
2026-11-06 Implementa e valida a operação offline da caneleira
    Persiste a prescrição e os resumos pendentes, recupera a sessão após reinício e sincroniza a sessão offline ao voltar ao broker.
    Validado com dados fictícios no Wokwi e MQTTX em 06/11/2026. Inclui roteiro, capturas dos três cenários do P11 e guias atualizados. A validação na placa física e no app Geratrix segue pendente.
    [caneleira.ino]
2026-11-06 Registra as limitações aceitas do P11 e a regra de integração do app
    - O app assina sessao/+ e confirma toda sessão recebida, inclusive a
    iniciada sem o app, cujo sid é criado pela caneleira; sem esse ack,
    a caneleira recusa prescrições novas
    - Limitações aceitas no README do firmware: sid sem ligação com o
    residente (correção com o campo origem testada e não aplicada), espera
    de 15 s numa rede lenta e opções de teste só para o Wokwi
    - P11 registrado como feito pelo Rafael; integração pelo grupo depois da
    refatoração para Flutter, com back-end mínimo para a tela que liga os
    projetos
    - Seção 8 do guia aponta para a ordem atual em como-continuar
    Co-Authore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
2026-11-06 Estima a autonomia com o power bank do grupo (P12)
    - docs/autonomia.md: power bank i2GO PROBAT018 (74 Wh), correntes por
    estado com fontes dos datasheets, perfil de duas sessões diárias de
    10 min, I média de 15 mA e autonomia de cerca de 33 dias, ou 98 h em
    uso contínuo
    - Cenário em que o power bank se desliga no deep sleep, riscos de peso e
    tamanho e tabela de medição para a fase física
    - Guias atualizados com a situação do P12
    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
2026-11-06 Declara o protocolo de validação enxuto (P14)
    - Ângulo em bancada contra transferidor: 5 leituras em 0°, 30°, 60° e
    90°, erro aceitável de ±5° por leitura
    - Contagem de repetições contra contagem manual: 3 participantes x 10
    repetições, acerto mínimo de 90%
    - Verificações de funcionamento uma vez cada: uso efetivo, biofeedback,
    queda de conexão e aquecimento
    - Regras do enunciado: só integrantes, sem nome nos registros, notebook
    fora da tomada nos ensaios com pessoa
    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
2026-11-07 Registra a integração do app Flutter com a caneleira no Wokwi
    - O app Geratrix (branch es/caneleira-mqtt) enviou a prescrição pelo
    cmd, mostrou o estado e recebeu as duas séries da sessão smw6yvs8l
    - Os ack saíram do app sozinhos; o último apagou a mensagem retida
    - Monitor serial resumido, com as linhas repetidas marcadas, e prints
    do app com a caneleira desligada e com a sessão concluída
    - Pendente: teste de queda de conexão com o app
    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
2026-11-08 Implementa o botão e o deep sleep da caneleira (P12) e documenta a montagem (P13)
    - Cada série começa pelo botão (GPIO 33, com debounce em botao.h); o botão
    também encerra o descanso e antecipa a partida offline do P11.
    - Deep sleep (energia.h) nos descansos de 20 s ou mais, com despertar pelo
    timer ou pelo botão, e após 5 min ocioso, só pelo botão. Antes de dormir,
    publica {"online":false}, desliga o Wi-Fi e põe a MPU-6050 em sleep; ao
    acordar, recupera a sessão da NVS. Contrato MQTT inalterado.
    - docs/montagem-protoboard.md: esquema elétrico e posição de cada peça na
    protoboard de 400 pontos montada em 08/11, sem a ESP32.
    - Teste de bancada da placa em firmware/te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
